leazer/vibranode-probe/LICENSING.md

# Licensing

The first-party software identified below is available under the [PolyForm Noncommercial License 1.0.0](LICENSE-PolyForm-Noncommercial-1.0.0.md). Commercial use of that software requires a separate grant from the relevant rights holder. Contact the maintainer through the original GitHub project for commercial licensing.

Required Notice: Copyright (c) 2026 煲仔卤煮 (ZealerLu)

This grant covers only material for which the project author holds the necessary rights. Existing third-party license and copyright notices remain applicable to the corresponding material.

The first-party software covered here is the original VibraNode probe code in `project/src/probe_*.c` and `project/inc/probe_*.h`, together with the original PC test client `tests/pc_host.py`. This grant excludes vendor code, bundled middleware and hardware design material.

The `libraries/` and `middlewares/` trees and vendor-supplied project templates retain their applicable terms, including the notices in [SEGGER RTT](middlewares/SEGGER_RTT_V798g/LICENSE.md) and [AGM](middlewares/agm/LICENSE.txt).
