leazer/vibranode-probe/docs/milestones/2026-09-07-calib-storage.md

# M8 校准与 Flash 保存

## 2026-09-08 线缆接口与 ICM 加速度

- 记录升级为v3：保留ADXL加速度与ICM陀螺字段，新增独立ICM加速度偏置/比例与有效位；有效v2记录可迁移到RAM，下一次显式保存写v3。
- `probe_calib`持有单一非阻塞会话状态：两组六面均值、窗口统计、连续性、超时、候选与dirty标志。ADXL/ICM加速度按当前量程计算名义灵敏度，ICM陀螺按当前量程换算；每面/静止窗口采集当前ODR约1秒。
- CALIBRATE 0x07支持查询、开始单面/陀螺窗口、取消、清进度；SAVE_CAL 0x08支持读RAM候选和双路停止后显式保存。PC主机支持完整六面、单面断点、陀螺窗口、读取及可选保存。
- 标定只观察已成功上传并即将释放的原始批次；TX忙重试不会重复计入。交互等待期间主机持续FETCH并在开始窗口前排空旧队列，避免4Mbps空闲回退与陈旧批次污染。

仿真覆盖ICM六面拟合、200SPS逐面窗口、v2迁移、v3双记录/掉电中断、协议状态/记录编码、停止后保存幂等；全部组件回归通过。模式0最终完整Rebuild 0错0警：Code53528/RO2324/RW16/ZI29792，SRAM余量2960字节（约2.9KiB）。

实板COM13/4Mbps/slow：0x08读取空白v3默认记录成功；ICM陀螺200样本静止窗口通过两次，未写Flash，最近候选约`(-0.2334,-0.3386,-0.0835)dps`、温度32.246°C；ICM加速度+Z单面200样本通过，完成掩码0x10。交互等待约14秒仍维持ADXL250SPS/ICM约198SPS、CRC零。其余五面和完整拟合需要人工翻转探头，尚未实板完成；当前候选未保存。

日期：2026-09-07，2026-09-08补齐线缆入口。开发分支 `codex/probe-foundation`，前一里程碑 `6083b8b`。依据：[探头设计](../../../../../docs/superpowers/specs/2026-09-06-vibranode-probe-design.md) 第 7 节。

## 本次实现

- `probe_calib` 组件：
  - 六面加速度校准代数拟合（每轴 ±1 g 对：比例 = (p−n)/2 counts/g，零偏 = (p+n)/2），输出按规范语义保存：`accel_bias_g` 物理单位、`accel_scale` 无量纲修正系数（(raw−bias)×scale = g）。内置质量门：任一轴 counts/g 偏离 ±10 g 名义值 50% 以上拒绝，轴间比例差超过 5% 拒绝。
  - 陀螺静止零偏拟合（输入已换算 dps）。
  - 双记录 Flash 存储：256 KB 末两个 2 KB 扇区各存一份记录（magic/version/有效位/三轴零偏与比例/温度/时间戳/CRC-32C），保存写入较旧槽位（掉电不破坏新记录），上电取最新有效记录，CRC 损坏自动回退，全部无效回退默认（比例 1、零偏 0）。
- 上电加载接入生产模式。

## 验证

- calib 仿真测试：注入已知零偏/灵敏度误差的六面数据 → 零偏恢复 ±0.001 g、比例恢复 ±0.001；姿态错乱触发质量门拒绝；保存/重启加载/双记录轮换/损坏回退全部通过；假 Flash 按扇区粒度擦除。
- 全部 10 个测试组件回归通过；Keil 完整 Rebuild 0 错误 0 警告：Code=43532、RO-data=2424、RW-data=16、ZI-data=27040（SRAM 32 KB 余量约 5.7 KB）。
- HEX SHA256：`1A19802ED82F315A9238E9D147BB65CC7EDE412FCBA8B2F20E8E7F360D964127`。

## 尚未验收的边界

Flash 擦写耐久、真实断电时序、ADXL完整六面和ICM其余五面仍未上板验证。校准记录仅存储未应用，应用在 TAB5 分析端。
