leazer/vibranode-probe/docs/milestones/2026-09-07-rtt-board-feedback.md

# 首轮单板 RTT 实板反馈与修复

用户回传日志包含旧M2、M3和新版BOARD多段；本结论仅分析行3454起的新版单板段（929条BOARD日志）。原附件SHA256：`d64f14b0dc2f50c5f3a6ad74321075f5d3f481a1a5213811cd1f455ee0e32ab0`。日志覆盖上电至约246秒，中间有明显输出缺口及连接中断，不是完整连续记录，也未达到30分钟验收。

## 实板观察

- 所有已输出的BOARD `spi/ovr/fmt/qdrop/attdrop/fault` 均为0，默认档首末样本计数差对应ADXL约4054.04 SPS、ICM约8038.43 SPS；后段32k档约32154.27 SPS。计数与消费数相等，未观察到队列丢失。
- ADXL默认档 `time_valid=1`，周期约16166000 Q16.16（约246.67 µs）。ICM高速档IRQ计数保持不变、样本持续增加，但 `time_valid/tick_valid` 不收敛。200 SPS短暂出现有效，记录不足以判断长期表现。
- 默认档AGM `valid=1`、processed持续增长，切到非8k档关闭，回到8k重新运行。仅证明本轮输出存在，不代表振动下姿态精度、轴向或yaw漂移已验收。
- `g` 在约115.140秒启动，约116.135秒通过；候选陀螺零偏为−0.224/−0.330/−0.098 dps，flags=2、dirty=1。运行中`v`正确拒绝。未见 `x/w/SAVE PASS`，因此未验证Flash写入/掉电/重载；也未执行ADXL六面流程。
- 最大观测单轮耗时：采集117 µs，姿态578 µs，总轮询991 µs。所有88条栈报告均为0/2048，不能用本日志验收栈预算。

## 根因和修复

1. **栈水位失真**：默认链接的STACK仍被ARM C运行库作为ZI清零。首版在Reset_Handler中填充，执行到`__main`后就被清掉。用实际AXF执行Reset→CRT→main已复现；首版测试停在SystemInit之前，漏测CRT，这是测试覆盖缺陷。
   - 改为main第一步调用leaf汇编`probe_stack_init`，在CRT之后、板级初始化之前，只填充栈底到当前MSP，保留活动栈帧。水位覆盖之后执行的板级初始化、应用、中断，不覆盖之前的CRT/SystemInit。
   - 不因旧日志0值盲目扩大栈；仍保留2 KiB，必须用新镜像确认真实余量。旧0值不排除其他实际栈风险。
2. **ICM时钟映射依赖停止更新的水位IRQ**：轮询及时排空FIFO后，水位条件不再成立；样本仍正常产生，但估计器拿不到新IRQ锚点。
   - ICM改用FIFO_COUNT请求/完成时刻中点，减去半周期样本年龄；超过512 B时减去仍留在FIFO尾部的样本时长，使锚点对应本批实际末样本。
   - ICM周期和tick比例采用至少100 ms观测跨度，连续8次一致才有效。ADXL保留DRDY与10 ms跨度。此观测包含SPI请求/主循环收割延迟及采样相位误差，不具有精确IRQ捕获的含义，绝对精度仍需外部时基验证。
3. **批次时间未随序号投影**：旧公式把保留的anchor_us当作每批新末样本时刻，估计窗口内批首时间会重复。现在按当前first_sequence相对anchor_seq投影。
4. **TIME_INFO仍用旧IRQ时间**：改为与first_sensor_tick/first_sequence对应的first_sample_us；线上字段布局不变。真实485/TAB5验证继续后移。

## 软件验证

- 现场回归模型由独立124 µs时钟产生ICM样本，FIFO低于水位、没有ICM IRQ；修复前不能收敛，修复后time/tick均有效、估计周期符合独立时钟，并验证相邻批首时间推进。
- 追加200/16000/32000 SPS无IRQ场景，均通过。仿真未涵盖所有寄存器采样相位和>512 B积压时的绝对误差分布，需结合实板数据继续评估。
- 协议测试无ICM IRQ时TIME_INFO时间推进且与对应STREAM批首时刻相等；修复前失败，修复后通过。
- 实际AXF验证执行完整CRT（仅跳过硬件SystemInit），停于板级时钟初始化入口，检查水位未被清除、检测人工覆盖，并检查链接段未侵入Flash标定区。
- 11个组件回归和时间回绕测试通过；四模式完整Rebuild均0错误0警告。只读审查发现的TIME_INFO关联问题已修复。

| 模式 | Code | RO | RW | ZI |
|---|---:|---:|---:|---:|
| 0 | 43944 | 2424 | 16 | 27336 |
| 1 | 18212 | 1756 | 16 | 6256 |
| 2 | 21696 | 2052 | 16 | 15248 |
| 3 | 47336 | 4000 | 16 | 22408 |

模式3剩余RAM10344 B（约10.1 KiB），模式0剩余5416 B（约5.3 KiB），均含2 KiB栈预留。新增两个64位COUNT时刻集中在各设备上下文，总ZI增加32 B。

默认模式3镜像 `project/MDK_V5/objects/VibraNode.hex`，SHA256：`CD9921E070ABC0871698F15C463887A5C0885D68E5CDEE1BA71C5A2633E252AF`。

## 下一步

重新烧录修复版模式3，默认静止10秒，检查ICM两个valid位及真实栈余量；随后2/3/4各至少10秒再回1。先依据新水位/错误计数决定是否继续长时/校准写Flash；不把本轮软件修复声称为实板验收通过。步骤见 [HARDWARE_CHECK_RTT.md](../HARDWARE_CHECK_RTT.md)。

## 修复版第二轮实板反馈（2026-09-07）

附件SHA256 `09317e0c053fe7e53cfc61d0c8b11841cfd5feda4de2ad10fef1527111c01d84`，610行，约0～67秒；上电后到9秒存在输出缺口，不能据此确定首次收敛的精确时刻。顺序默认→4（32k）→3（16k）→2（250/200）→1（默认）。

- 所有已输出spi/ovr/fmt/qdrop/attdrop/fault为0，seg=1、gap=0，消费数跟随样本数。默认档32秒计数窗口约ADXL4054.05/ICM8038.37 SPS；32k档7秒窗口32154.71 SPS；16k档8秒窗口16077.12 SPS。低速仅短窗口，约ADXL253.5/ICM201 SPS，不作精度验收。
- ICM在200/8k/16k/32k均出现time_valid=1、tick_valid=1。默认初段uncertain_batches保持3461不增长，返回默认后稳定3483；切档后短暂无效属于重新估计。说明无持续水位IRQ的收敛修复在这些短时档位得到实板验证。
- 全部59条栈报告均1280/2048，覆盖边界约用768字节；此前0报告确属无效水位，现仪表有实际读数。本轮未覆盖六面、保存Flash等调用路径，不将1280字节余量解释为全路径保证。
- PERF累计最大值：acq116 µs、attitude421 µs、loop983 µs；采集层poll_gap最大984 µs。AGM默认档valid=1且持续输出，非8k档关闭，回到8k重新运行。
- ICM稳态tick_q16约69570（约1.0616 MCU µs/tick），不同高速ODR接近一致；这是映射估计值，不强行当作名义1 µs，也不据此声称绝对时间精度已验收。外部时基验证仍待执行。
- 本轮没有校准/保存命令，启动flags=0；不能声称Flash、六面或长时已通过。

下一步：保持当前固件，默认档长时运行至少30分钟，记录末尾错误计数/PERF/栈；验证x/s/r、LED巡检及静止/轻缓转动。随后g→通过→x→两路stop=1→w→v→复位核对generation/系数，再做ADXL六面。485/TAB5继续后移。本次仅记录验证结果，无固件修改。
