leazer/vibranode-probe/docs/superpowers/plans/2026-09-07-sensor-components.md

# 传感器组件分层整改

目标：保留 M2 已实测行为，分离芯片操作和板级调用，不在本次重构中增加 FIFO 或正式协议。

依据：用户本轮审查要求及仓库 AGENTS.md。使用现有固件分支继续执行。

- [x] 将参考库的必要寄存器定义归入 middlewares，保留来源与版权。
- [x] ADXL357、ICM42688 分别提供无 MCU 依赖的命令编码、身份检查、快照解析和明确命名的诊断配置。
- [x] probe_validation 只保留诊断编排、状态和统计；SPI DMA 继续拥有异步缓冲。
- [x] CS、LED、RS485 DIR 统一使用 wk_config 的板级宏，增加后续开发约束。
- [x] 验证重构前后寄存器事务一致、状态机回归、SPI 回归和 Keil 全量编译，检查 diff 后提交。

状态所有权：芯片描述与配置为只读常量；芯片操作无持久状态。诊断上下文拥有诊断进度、计数、最后一次样本；DMA 上下文拥有传输缓冲和完成状态。后续连续采集状态属于采集组件，不能继续加入诊断上下文。
