leazer/vibranode-probe/docs/milestones/2026-10-12-on-board-calibration.md

# 2026-10-12 实板标定收官（ADXL 六面 + ICM 加计六面 + ICM 陀螺静态）

## 结果

最终记录 v3：`flags=0x07、generation=3、temp_c=30.4`；断电重上电后 `--read-cal`
读回与保存时逐位一致——双槽 + generation + CRC 的持久化与加载链路闭环。

| 目标 | bias | scale |
| --- | --- | --- |
| ADXL 加计 | (−46.84, +47.08, +16.58) mg | (1.03926, 1.02806, 1.07403) |
| ICM 加计 | (−0.31, −1.09, +9.37) mg | (1.00067, 1.00088, 1.00117) |
| ICM 陀螺 | (+0.190, −0.650, +0.674) dps | —（静态零偏） |

## 过程与判读

- 首跑 +X 面被拒（sample_count=250 采满、last_result=REJECTED、采集健康）→
  `pc_host --inspect` 扩展逐轴 mean/std（`9a4a389`）取证 → 根因=
  **PCB 丝印 X/Y 标反**：丝印 +X=传感器 +Y、丝印 +Y=传感器 +X，Z 与极性
  正确；ADXL 与 ICM 两片映射一致 → 板级丝印层错，非器件贴装差。
- 处置：固件/协议零改动（数据、标定记录、姿态全在传感器系）；人工放板按
  传感器系（+X 提示→丝印 Y 朝上，+Y 提示→丝印 X 朝上，±Z 不变）。
- ADXL scale≈1.03 是预期基线：固件 nominal 用 2²⁰ 理想值 52428.8 LSB/g，
  典型灵敏度 51200 LSB/g。Z 的 1.074 曾疑出线端面线缆污染，被**新朝向复现
  检验**否定：两拍独立 dump 代入 corrected=(raw/52428.8−bias)·scale 得
  |g|=1.0002 / 1.0004 → Z 是该片真实灵敏度（较典型 −4.7%），X/Y ±47mg 镜像
  bias 为真实零偏（(p+n)/2 精确恢复；几何倾斜只贡献 ~11mg 量级）。
- ICM 陀螺偏置与两拍独立 dump（+0.205/−0.635/+0.647、+0.203/−0.655/+0.661
  dps）一致，静态可标。
- 工程量：每面 1 s 采集（紫 5 Hz），朝向门 ≤~8.6°（出线端面书堆搭桥、线缆
  留松弛防方差门拒收）。

## 工具

- `pc_host`：`--calibrate adxl-accel|icm-accel|icm-gyro [--face N]` +
  `--save-cal` + `--read-cal`；`--inspect` 打印 ADXL 三轴 / ICM 六轴
  mean±std（slow 配置换算 g/dps），标定诊断与记录复核两用。
- 下一块板：丝印修版前，标定放板沿用本文映射表（X/Y 互换）。

## 遗留观察

- icm_a（侧立）末帧姿态四元数与 90° 倾斜姿态不符——待姿态专项验证时核对
  参考系定义/收尾晃动，不阻塞标定与产品档位。
- LED 故障注入（测量中拔 ADXL=红常亮、拔 ICM=红 5 Hz 闪）仍未做。
