leazer/vibranode-probe/project/inc/at32f413_wk_config.h

/* add user code begin Header */
/**
  **************************************************************************
  * @file     at32f413_wk_config.h
  * @brief    header file of work bench config
  **************************************************************************
  * Copyright (c) 2025, Artery Technology, All rights reserved.
  *
  * The software Board Support Package (BSP) that is made available to
  * download from Artery official website is the copyrighted work of Artery.
  * Artery authorizes customers to use, copy, and distribute the BSP
  * software and its related documentation for the purpose of design and
  * development in conjunction with Artery microcontrollers. Use of the
  * software is governed by this copyright notice and the following disclaimer.
  *
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
  **************************************************************************
  */
/* add user code end Header */

/* define to prevent recursive inclusion -----------------------------------*/
#ifndef __AT32F413_WK_CONFIG_H
#define __AT32F413_WK_CONFIG_H

#ifdef __cplusplus
extern "C" {
#endif

/* includes -----------------------------------------------------------------------*/
#include "stdio.h"
#include "at32f413.h"

/* private includes -------------------------------------------------------------*/
/* add user code begin private includes */
#include "wk_system.h"
/* add user code end private includes */

/* exported types -------------------------------------------------------------*/
/* add user code begin exported types */

/* add user code end exported types */

/* exported constants --------------------------------------------------------*/
/* add user code begin exported constants */

/* add user code end exported constants */

/* exported macro ------------------------------------------------------------*/
/* add user code begin exported macro */

/* add user code end exported macro */

/* add user code begin dma define */
/* user can only modify the dma define value */
//#define DMA1_CHANNEL1_BUFFER_SIZE   0
//#define DMA1_CHANNEL1_MEMORY_BASE_ADDR   0
//#define DMA1_CHANNEL1_PERIPHERAL_BASE_ADDR  0

//#define DMA1_CHANNEL2_BUFFER_SIZE   0
//#define DMA1_CHANNEL2_MEMORY_BASE_ADDR   0
//#define DMA1_CHANNEL2_PERIPHERAL_BASE_ADDR   0

//#define DMA1_CHANNEL3_BUFFER_SIZE   0
//#define DMA1_CHANNEL3_MEMORY_BASE_ADDR   0
//#define DMA1_CHANNEL3_PERIPHERAL_BASE_ADDR   0

//#define DMA1_CHANNEL4_BUFFER_SIZE   0
//#define DMA1_CHANNEL4_MEMORY_BASE_ADDR   0
//#define DMA1_CHANNEL4_PERIPHERAL_BASE_ADDR   0

//#define DMA1_CHANNEL5_BUFFER_SIZE   0
//#define DMA1_CHANNEL5_MEMORY_BASE_ADDR   0
//#define DMA1_CHANNEL5_PERIPHERAL_BASE_ADDR   0

//#define DMA1_CHANNEL6_BUFFER_SIZE   0
//#define DMA1_CHANNEL6_MEMORY_BASE_ADDR   0
//#define DMA1_CHANNEL6_PERIPHERAL_BASE_ADDR   0

//#define DMA1_CHANNEL7_BUFFER_SIZE   0
//#define DMA1_CHANNEL7_MEMORY_BASE_ADDR   0
//#define DMA1_CHANNEL7_PERIPHERAL_BASE_ADDR   0

//#define DMA2_CHANNEL1_BUFFER_SIZE   0
//#define DMA2_CHANNEL1_MEMORY_BASE_ADDR   0
//#define DMA2_CHANNEL1_PERIPHERAL_BASE_ADDR   0

//#define DMA2_CHANNEL2_BUFFER_SIZE   0
//#define DMA2_CHANNEL2_MEMORY_BASE_ADDR   0
//#define DMA2_CHANNEL2_PERIPHERAL_BASE_ADDR   0

//#define DMA2_CHANNEL3_BUFFER_SIZE   0
//#define DMA2_CHANNEL3_MEMORY_BASE_ADDR   0
//#define DMA2_CHANNEL3_PERIPHERAL_BASE_ADDR   0

//#define DMA2_CHANNEL4_BUFFER_SIZE   0
//#define DMA2_CHANNEL4_MEMORY_BASE_ADDR   0
//#define DMA2_CHANNEL4_PERIPHERAL_BASE_ADDR   0

//#define DMA2_CHANNEL5_BUFFER_SIZE   0
//#define DMA2_CHANNEL5_MEMORY_BASE_ADDR   0
//#define DMA2_CHANNEL5_PERIPHERAL_BASE_ADDR   0

//#define DMA2_CHANNEL6_BUFFER_SIZE   0
//#define DMA2_CHANNEL6_MEMORY_BASE_ADDR   0
//#define DMA2_CHANNEL6_PERIPHERAL_BASE_ADDR   0

//#define DMA2_CHANNEL7_BUFFER_SIZE   0
//#define DMA2_CHANNEL7_MEMORY_BASE_ADDR   0
//#define DMA2_CHANNEL7_PERIPHERAL_BASE_ADDR   0
/* add user code end dma define */

/* Private defines -------------------------------------------------------------*/
#define ADXL_CS_PIN    GPIO_PINS_4
#define ADXL_CS_GPIO_PORT    GPIOA
#define ADXL_CLK_PIN    GPIO_PINS_5
#define ADXL_CLK_GPIO_PORT    GPIOA
#define ADXL_MISO_PIN    GPIO_PINS_6
#define ADXL_MISO_GPIO_PORT    GPIOA
#define ADXL_MOSI_PIN    GPIO_PINS_7
#define ADXL_MOSI_GPIO_PORT    GPIOA
#define ADXL_DRDY_PIN    GPIO_PINS_0
#define ADXL_DRDY_GPIO_PORT    GPIOB
#define ADXL_INT1_PIN    GPIO_PINS_1
#define ADXL_INT1_GPIO_PORT    GPIOB
#define IMU_INT1_PIN    GPIO_PINS_10
#define IMU_INT1_GPIO_PORT    GPIOB
#define IMU_CS_PIN    GPIO_PINS_12
#define IMU_CS_GPIO_PORT    GPIOB
#define IMU_CLK_PIN    GPIO_PINS_13
#define IMU_CLK_GPIO_PORT    GPIOB
#define IMU_MISO_PIN    GPIO_PINS_14
#define IMU_MISO_GPIO_PORT    GPIOB
#define IMU_MOSI_PIN    GPIO_PINS_15
#define IMU_MOSI_GPIO_PORT    GPIOB
#define LED_R_PIN    GPIO_PINS_5
#define LED_R_GPIO_PORT    GPIOB
#define LED_G_PIN    GPIO_PINS_3
#define LED_G_GPIO_PORT    GPIOB
#define LED_B_PIN    GPIO_PINS_4
#define LED_B_GPIO_PORT    GPIOB

/* exported functions ------------------------------------------------------- */
  /* system clock config. */
  void wk_system_clock_config(void);

  /* config periph clock. */
  void wk_periph_clock_config(void);

  /* init debug function. */
  void wk_debug_config(void);

  /* nvic config. */
  void wk_nvic_config(void);

  /* init gpio function. */
  void wk_gpio_config(void);

  /* init exint function. */
  void wk_exint_config(void);

  /* init spi1 function. */
  void wk_spi1_init(void);

  /* init spi2 function. */
  void wk_spi2_init(void);

/* add user code begin exported functions */

/* add user code end exported functions */

#ifdef __cplusplus
}
#endif

#endif
