leazer/vibranode-probe/project/src/at32f413_wk_config.c

/* add user code begin Header */
/**
  **************************************************************************
  * @file     at32f413_wk_config.c
  * @brief    work bench config program
  **************************************************************************
  * Copyright (c) 2025, Artery Technology, All rights reserved.
  *
  * The software Board Support Package (BSP) that is made available to
  * download from Artery official website is the copyrighted work of Artery.
  * Artery authorizes customers to use, copy, and distribute the BSP
  * software and its related documentation for the purpose of design and
  * development in conjunction with Artery microcontrollers. Use of the
  * software is governed by this copyright notice and the following disclaimer.
  *
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
  **************************************************************************
  */
/* add user code end Header */

#include "at32f413_wk_config.h"

/* private includes ----------------------------------------------------------*/
/* add user code begin private includes */

/* add user code end private includes */

/* private typedef -----------------------------------------------------------*/
/* add user code begin private typedef */

/* add user code end private typedef */

/* private define ------------------------------------------------------------*/
/* add user code begin private define */

/* add user code end private define */

/* private macro -------------------------------------------------------------*/
/* add user code begin private macro */

/* add user code end private macro */

/* private variables ---------------------------------------------------------*/
/* add user code begin private variables */

/* add user code end private variables */

/* private function prototypes --------------------------------------------*/
/* add user code begin function prototypes */

/* add user code end function prototypes */

/* private user code ---------------------------------------------------------*/
/* add user code begin 0 */

/* add user code end 0 */

/**
  * @brief  system clock config program
  * @note   the system clock is configured as follow:
  *         system clock (sclk)   = hext / 2 * pll_mult
  *         system clock source   = HEXT_VALUE
  *         - hext                = HEXT_VALUE
  *         - sclk                = 200000000
  *         - ahbdiv              = 1
  *         - ahbclk              = 200000000
  *         - apb1div             = 2
  *         - apb1clk             = 100000000
  *         - apb2div             = 2
  *         - apb2clk             = 100000000
  *         - pll_mult            = 50
  *         - pll_range           = GT72MHZ (greater than 72 mhz)
  *         - usb clock           = HICK 48 MHz (see probe_usb.c). 200 MHz is
  *                                  the part maximum and is only reachable
  *                                  with the HICK USB clock (200/4 != 48).
  * @param  none
  * @retval none
  */
void wk_system_clock_config(void)
{
  /* reset crm */
  crm_reset();

  /* enable lick */
  crm_clock_source_enable(CRM_CLOCK_SOURCE_LICK, TRUE);

  /* wait till lick is ready */
  while(crm_flag_get(CRM_LICK_STABLE_FLAG) != SET)
  {
  }

  /* enable hext */
  crm_clock_source_enable(CRM_CLOCK_SOURCE_HEXT, TRUE);

  /* wait till hext is ready */
  while(crm_hext_stable_wait() == ERROR)
  {
  }

  /* enable hick */
  crm_clock_source_enable(CRM_CLOCK_SOURCE_HICK, TRUE);

  /* wait till hick is ready */
  while(crm_flag_get(CRM_HICK_STABLE_FLAG) != SET)
  {
  }

  /* config pll clock resource */
  crm_pll_config(CRM_PLL_SOURCE_HEXT_DIV, CRM_PLL_MULT_50, CRM_PLL_OUTPUT_RANGE_GT72MHZ);

  /* enable pll */
  crm_clock_source_enable(CRM_CLOCK_SOURCE_PLL, TRUE);

  /* wait till pll is ready */
  while(crm_flag_get(CRM_PLL_STABLE_FLAG) != SET)
  {
  }

  /* config ahbclk */
  crm_ahb_div_set(CRM_AHB_DIV_1);

  /* config apb2clk, the maximum frequency of APB2 clock is 100 MHz  */
  crm_apb2_div_set(CRM_APB2_DIV_2);

  /* config apb1clk, the maximum frequency of APB1 clock is 100 MHz  */
  crm_apb1_div_set(CRM_APB1_DIV_2);

  /* enable auto step mode */
  crm_auto_step_mode_enable(TRUE);

  /* select pll as system clock source */
  crm_sysclk_switch(CRM_SCLK_PLL);

  /* wait till pll is used as system clock source */
  while(crm_sysclk_switch_status_get() != CRM_SCLK_PLL)
  {
  }

  /* disable auto step mode */
  crm_auto_step_mode_enable(FALSE);

  /* update system_core_clock global variable */
  system_core_clock_update();
}

/**
  * @brief  config periph clock
  * @param  none
  * @retval none
  */
void wk_periph_clock_config(void)
{
  /* enable iomux periph clock */
  crm_periph_clock_enable(CRM_IOMUX_PERIPH_CLOCK, TRUE);

  /* enable gpioa periph clock */
  crm_periph_clock_enable(CRM_GPIOA_PERIPH_CLOCK, TRUE);

  /* enable gpiob periph clock */
  crm_periph_clock_enable(CRM_GPIOB_PERIPH_CLOCK, TRUE);

  /* enable gpiod periph clock */
  crm_periph_clock_enable(CRM_GPIOD_PERIPH_CLOCK, TRUE);

  /* enable spi1 periph clock */
  crm_periph_clock_enable(CRM_SPI1_PERIPH_CLOCK, TRUE);

  /* enable spi2 periph clock */
  crm_periph_clock_enable(CRM_SPI2_PERIPH_CLOCK, TRUE);
}

/**
  * @brief  init debug function.
  * @param  none
  * @retval none
  */
void wk_debug_config(void)
{
  /* jtag-dp disabled and sw-dp enabled */
  gpio_pin_remap_config(SWJTAG_GMUX_010, TRUE);
}

/**
  * @brief  nvic config
  * @param  none
  * @retval none
  */
void wk_nvic_config(void)
{
  nvic_priority_group_config(NVIC_PRIORITY_GROUP_4);

  NVIC_SetPriority(MemoryManagement_IRQn, NVIC_EncodePriority(NVIC_GetPriorityGrouping(), 0, 0));
  NVIC_SetPriority(BusFault_IRQn, NVIC_EncodePriority(NVIC_GetPriorityGrouping(), 0, 0));
  NVIC_SetPriority(UsageFault_IRQn, NVIC_EncodePriority(NVIC_GetPriorityGrouping(), 0, 0));
  NVIC_SetPriority(SVCall_IRQn, NVIC_EncodePriority(NVIC_GetPriorityGrouping(), 0, 0));
  NVIC_SetPriority(DebugMonitor_IRQn, NVIC_EncodePriority(NVIC_GetPriorityGrouping(), 0, 0));
  NVIC_SetPriority(PendSV_IRQn, NVIC_EncodePriority(NVIC_GetPriorityGrouping(), 15, 0));
  NVIC_SetPriority(SysTick_IRQn, NVIC_EncodePriority(NVIC_GetPriorityGrouping(), 15, 0));
}

/**
  * @brief  init gpio_input/gpio_output/gpio_analog/eventout function.
  * @param  none
  * @retval none
  */
void wk_gpio_config(void)
{
  /* add user code begin gpio_config 0 */

  /* add user code end gpio_config 0 */

  gpio_init_type gpio_init_struct;
  gpio_default_para_init(&gpio_init_struct);

  /* add user code begin gpio_config 1 */

  /* add user code end gpio_config 1 */

  /* gpio output config */
  gpio_bits_set(ADXL_CS_GPIO_PORT, ADXL_CS_PIN);
  gpio_bits_set(IMU_CS_GPIO_PORT, IMU_CS_PIN);
  gpio_bits_set(LED_R_GPIO_PORT, LED_R_PIN);
  gpio_bits_set(LED_G_GPIO_PORT, LED_G_PIN);
  gpio_bits_set(LED_B_GPIO_PORT, LED_B_PIN);

  gpio_init_struct.gpio_drive_strength = GPIO_DRIVE_STRENGTH_MODERATE;
  gpio_init_struct.gpio_out_type = GPIO_OUTPUT_PUSH_PULL;
  gpio_init_struct.gpio_mode = GPIO_MODE_OUTPUT;
  gpio_init_struct.gpio_pins = ADXL_CS_PIN;
  gpio_init_struct.gpio_pull = GPIO_PULL_NONE;
  gpio_init(GPIOA, &gpio_init_struct);

  gpio_init_struct.gpio_drive_strength = GPIO_DRIVE_STRENGTH_MODERATE;
  gpio_init_struct.gpio_out_type = GPIO_OUTPUT_PUSH_PULL;
  gpio_init_struct.gpio_mode = GPIO_MODE_OUTPUT;
  gpio_init_struct.gpio_pins = IMU_CS_PIN | LED_R_PIN | LED_G_PIN | LED_B_PIN;
  gpio_init_struct.gpio_pull = GPIO_PULL_NONE;
  gpio_init(GPIOB, &gpio_init_struct);

  /* add user code begin gpio_config 2 */

  /* add user code end gpio_config 2 */
}

/**
  * @brief  init exint function.
  * @param  none
  * @retval none
  */
void wk_exint_config(void)
{
  /* add user code begin exint_config 0 */

  /* add user code end exint_config 0 */

  gpio_init_type gpio_init_struct;
  exint_init_type exint_init_struct;

  /* add user code begin exint_config 1 */

  /* add user code end exint_config 1 */

  /* configure the EXINT0 */
  gpio_default_para_init(&gpio_init_struct);
  gpio_init_struct.gpio_mode = GPIO_MODE_INPUT;
  gpio_init_struct.gpio_pins = ADXL_DRDY_PIN;
  gpio_init_struct.gpio_pull = GPIO_PULL_NONE;
  gpio_init(ADXL_DRDY_GPIO_PORT, &gpio_init_struct);

  gpio_exint_line_config(GPIO_PORT_SOURCE_GPIOB, GPIO_PINS_SOURCE0);

  exint_default_para_init(&exint_init_struct);
  exint_init_struct.line_enable = TRUE;
  exint_init_struct.line_mode = EXINT_LINE_INTERRUPUT;
  exint_init_struct.line_select = EXINT_LINE_0;
  exint_init_struct.line_polarity = EXINT_TRIGGER_RISING_EDGE;
  exint_init(&exint_init_struct);

  /* configure the EXINT1 */
  gpio_default_para_init(&gpio_init_struct);
  gpio_init_struct.gpio_mode = GPIO_MODE_INPUT;
  gpio_init_struct.gpio_pins = ADXL_INT1_PIN;
  gpio_init_struct.gpio_pull = GPIO_PULL_NONE;
  gpio_init(ADXL_INT1_GPIO_PORT, &gpio_init_struct);

  gpio_exint_line_config(GPIO_PORT_SOURCE_GPIOB, GPIO_PINS_SOURCE1);

  exint_default_para_init(&exint_init_struct);
  exint_init_struct.line_enable = TRUE;
  exint_init_struct.line_mode = EXINT_LINE_INTERRUPUT;
  exint_init_struct.line_select = EXINT_LINE_1;
  exint_init_struct.line_polarity = EXINT_TRIGGER_RISING_EDGE;
  exint_init(&exint_init_struct);

  /* configure the EXINT10 */
  gpio_default_para_init(&gpio_init_struct);
  gpio_init_struct.gpio_mode = GPIO_MODE_INPUT;
  gpio_init_struct.gpio_pins = IMU_INT1_PIN;
  gpio_init_struct.gpio_pull = GPIO_PULL_NONE;
  gpio_init(IMU_INT1_GPIO_PORT, &gpio_init_struct);

  gpio_exint_line_config(GPIO_PORT_SOURCE_GPIOB, GPIO_PINS_SOURCE10);

  exint_default_para_init(&exint_init_struct);
  exint_init_struct.line_enable = TRUE;
  exint_init_struct.line_mode = EXINT_LINE_INTERRUPUT;
  exint_init_struct.line_select = EXINT_LINE_10;
  exint_init_struct.line_polarity = EXINT_TRIGGER_RISING_EDGE;
  exint_init(&exint_init_struct);

  /* add user code begin exint_config 2 */

  /* add user code end exint_config 2 */
  
  /* add user code begin exint_config 3 */

  /* add user code end exint_config 3 */
}

/**
  * @brief  init spi1 function
  * @param  none
  * @retval none
  */
void wk_spi1_init(void)
{
  /* add user code begin spi1_init 0 */

  /* add user code end spi1_init 0 */

  gpio_init_type gpio_init_struct;
  spi_init_type spi_init_struct;

  gpio_default_para_init(&gpio_init_struct);
  spi_default_para_init(&spi_init_struct);

  /* add user code begin spi1_init 1 */

  /* add user code end spi1_init 1 */

  /* configure the SCK pin */
  gpio_init_struct.gpio_drive_strength = GPIO_DRIVE_STRENGTH_MODERATE;
  gpio_init_struct.gpio_out_type = GPIO_OUTPUT_PUSH_PULL;
  gpio_init_struct.gpio_mode = GPIO_MODE_MUX;
  gpio_init_struct.gpio_pins = ADXL_CLK_PIN;
  gpio_init_struct.gpio_pull = GPIO_PULL_NONE;
  gpio_init(ADXL_CLK_GPIO_PORT, &gpio_init_struct);

  /* configure the MISO pin */
  gpio_init_struct.gpio_drive_strength = GPIO_DRIVE_STRENGTH_MODERATE;
  gpio_init_struct.gpio_out_type  = GPIO_OUTPUT_PUSH_PULL;
  gpio_init_struct.gpio_mode = GPIO_MODE_INPUT;
  gpio_init_struct.gpio_pins = ADXL_MISO_PIN;
  gpio_init_struct.gpio_pull = GPIO_PULL_NONE;
  gpio_init(ADXL_MISO_GPIO_PORT, &gpio_init_struct);

  /* configure the MOSI pin */
  gpio_init_struct.gpio_drive_strength = GPIO_DRIVE_STRENGTH_MODERATE;
  gpio_init_struct.gpio_out_type = GPIO_OUTPUT_PUSH_PULL;
  gpio_init_struct.gpio_mode = GPIO_MODE_MUX;
  gpio_init_struct.gpio_pins = ADXL_MOSI_PIN;
  gpio_init_struct.gpio_pull = GPIO_PULL_NONE;
  gpio_init(ADXL_MOSI_GPIO_PORT, &gpio_init_struct);

  /* configure param */
  spi_init_struct.transmission_mode = SPI_TRANSMIT_FULL_DUPLEX;
  spi_init_struct.master_slave_mode = SPI_MODE_MASTER;
  spi_init_struct.frame_bit_num = SPI_FRAME_8BIT;
  spi_init_struct.first_bit_transmission = SPI_FIRST_BIT_MSB;
  spi_init_struct.mclk_freq_division = SPI_MCLK_DIV_16;
  spi_init_struct.clock_polarity = SPI_CLOCK_POLARITY_LOW;
  spi_init_struct.clock_phase = SPI_CLOCK_PHASE_1EDGE;
  spi_init_struct.cs_mode_selection = SPI_CS_SOFTWARE_MODE;
  spi_init(SPI1, &spi_init_struct);

  /* add user code begin spi1_init 2 */

  /* add user code end spi1_init 2 */

  spi_enable(SPI1, TRUE);

  /* add user code begin spi1_init 3 */

  /* add user code end spi1_init 3 */
}

/**
  * @brief  init spi2 function
  * @param  none
  * @retval none
  */
void wk_spi2_init(void)
{
  /* add user code begin spi2_init 0 */

  /* add user code end spi2_init 0 */

  gpio_init_type gpio_init_struct;
  spi_init_type spi_init_struct;

  gpio_default_para_init(&gpio_init_struct);
  spi_default_para_init(&spi_init_struct);

  /* add user code begin spi2_init 1 */

  /* add user code end spi2_init 1 */

  /* configure the SCK pin */
  gpio_init_struct.gpio_drive_strength = GPIO_DRIVE_STRENGTH_MODERATE;
  gpio_init_struct.gpio_out_type = GPIO_OUTPUT_PUSH_PULL;
  gpio_init_struct.gpio_mode = GPIO_MODE_MUX;
  gpio_init_struct.gpio_pins = IMU_CLK_PIN;
  gpio_init_struct.gpio_pull = GPIO_PULL_NONE;
  gpio_init(IMU_CLK_GPIO_PORT, &gpio_init_struct);

  /* configure the MISO pin */
  gpio_init_struct.gpio_drive_strength = GPIO_DRIVE_STRENGTH_MODERATE;
  gpio_init_struct.gpio_out_type  = GPIO_OUTPUT_PUSH_PULL;
  gpio_init_struct.gpio_mode = GPIO_MODE_INPUT;
  gpio_init_struct.gpio_pins = IMU_MISO_PIN;
  gpio_init_struct.gpio_pull = GPIO_PULL_NONE;
  gpio_init(IMU_MISO_GPIO_PORT, &gpio_init_struct);

  /* configure the MOSI pin */
  gpio_init_struct.gpio_drive_strength = GPIO_DRIVE_STRENGTH_MODERATE;
  gpio_init_struct.gpio_out_type = GPIO_OUTPUT_PUSH_PULL;
  gpio_init_struct.gpio_mode = GPIO_MODE_MUX;
  gpio_init_struct.gpio_pins = IMU_MOSI_PIN;
  gpio_init_struct.gpio_pull = GPIO_PULL_NONE;
  gpio_init(IMU_MOSI_GPIO_PORT, &gpio_init_struct);

  /* configure param */
  spi_init_struct.transmission_mode = SPI_TRANSMIT_FULL_DUPLEX;
  spi_init_struct.master_slave_mode = SPI_MODE_MASTER;
  spi_init_struct.frame_bit_num = SPI_FRAME_8BIT;
  spi_init_struct.first_bit_transmission = SPI_FIRST_BIT_MSB;
  spi_init_struct.mclk_freq_division = SPI_MCLK_DIV_8;
  spi_init_struct.clock_polarity = SPI_CLOCK_POLARITY_LOW;
  spi_init_struct.clock_phase = SPI_CLOCK_PHASE_1EDGE;
  spi_init_struct.cs_mode_selection = SPI_CS_SOFTWARE_MODE;
  spi_init(SPI2, &spi_init_struct);

  /* add user code begin spi2_init 2 */

  /* add user code end spi2_init 2 */

  spi_enable(SPI2, TRUE);

  /* add user code begin spi2_init 3 */

  /* add user code end spi2_init 3 */
}

/* add user code begin 1 */

/* add user code end 1 */
