leazer/vibranode-probe/project/src/at32f413_int.c

/* add user code begin Header */
/**
  **************************************************************************
  * @file     at32f413_int.c
  * @brief    main interrupt service routines.
  **************************************************************************
  * Copyright (c) 2025, Artery Technology, All rights reserved.
  *
  * The software Board Support Package (BSP) that is made available to
  * download from Artery official website is the copyrighted work of Artery.
  * Artery authorizes customers to use, copy, and distribute the BSP
  * software and its related documentation for the purpose of design and
  * development in conjunction with Artery microcontrollers. Use of the
  * software is governed by this copyright notice and the following disclaimer.
  *
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
  **************************************************************************
  */
/* add user code end Header */

/* includes ------------------------------------------------------------------*/
#include "at32f413_int.h"
#include "wk_system.h"
/* private includes ----------------------------------------------------------*/
/* add user code begin private includes */
#include "probe_time.h"
#include "probe_spi.h"
#include "probe_validation.h"
#include "probe_acquisition.h"
#include "probe_usb.h"

/* add user code end private includes */

/* private typedef -----------------------------------------------------------*/
/* add user code begin private typedef */

/* add user code end private typedef */

/* private define ------------------------------------------------------------*/
/* add user code begin private define */

/* add user code end private define */

/* private macro -------------------------------------------------------------*/
/* add user code begin private macro */

/* add user code end private macro */

/* private variables ---------------------------------------------------------*/
/* add user code begin private variables */

/* add user code end private variables */

/* private function prototypes --------------------------------------------*/
/* add user code begin function prototypes */

/* add user code end function prototypes */

/* private user code ---------------------------------------------------------*/
/* add user code begin 0 */

/* add user code end 0 */

/* external variables ---------------------------------------------------------*/
/* add user code begin external variables */

/* add user code end external variables */

/**
  * @brief  this function handles nmi exception.
  * @param  none
  * @retval none
  */
void NMI_Handler(void)
{
  /* add user code begin NonMaskableInt_IRQ 0 */

  /* add user code end NonMaskableInt_IRQ 0 */

  /* add user code begin NonMaskableInt_IRQ 1 */

  /* add user code end NonMaskableInt_IRQ 1 */
}

/**
  * @brief  this function handles hard fault exception.
  * @param  none
  * @retval none
  */
void HardFault_Handler(void)
{
  /* add user code begin HardFault_IRQ 0 */

  /* add user code end HardFault_IRQ 0 */
  /* go to infinite loop when hard fault exception occurs */
  while (1)
  {
    /* add user code begin W1_HardFault_IRQ 0 */

    /* add user code end W1_HardFault_IRQ 0 */
  }
}


/**
  * @brief  this function handles memory manage exception.
  * @param  none
  * @retval none
  */
void MemManage_Handler(void)
{
  /* add user code begin MemoryManagement_IRQ 0 */

  /* add user code end MemoryManagement_IRQ 0 */
  /* go to infinite loop when memory manage exception occurs */
  while (1)
  {
    /* add user code begin W1_MemoryManagement_IRQ 0 */

    /* add user code end W1_MemoryManagement_IRQ 0 */
  }
}

/**
  * @brief  this function handles bus fault exception.
  * @param  none
  * @retval none
  */
void BusFault_Handler(void)
{
  /* add user code begin BusFault_IRQ 0 */

  /* add user code end BusFault_IRQ 0 */
  /* go to infinite loop when bus fault exception occurs */
  while (1)
  {
    /* add user code begin W1_BusFault_IRQ 0 */

    /* add user code end W1_BusFault_IRQ 0 */
  }
}

/**
  * @brief  this function handles usage fault exception.
  * @param  none
  * @retval none
  */
void UsageFault_Handler(void)
{
  /* add user code begin UsageFault_IRQ 0 */

  /* add user code end UsageFault_IRQ 0 */
  /* go to infinite loop when usage fault exception occurs */
  while (1)
  {
    /* add user code begin W1_UsageFault_IRQ 0 */

    /* add user code end W1_UsageFault_IRQ 0 */
  }
}

/**
  * @brief  this function handles debug monitor exception.
  * @param  none
  * @retval none
  */
void DebugMon_Handler(void)
{
  /* add user code begin DebugMonitor_IRQ 0 */

  /* add user code end DebugMonitor_IRQ 0 */
  /* add user code begin DebugMonitor_IRQ 1 */

  /* add user code end DebugMonitor_IRQ 1 */
}

/**
  * @brief  this function handles systick handler.
  * @param  none
  * @retval none
  */
void SysTick_Handler(void)
{
  /* add user code begin SysTick_IRQ 0 */

  /* add user code end SysTick_IRQ 0 */

  wk_timebase_handler();
  /* add user code begin SysTick_IRQ 1 */

  /* add user code end SysTick_IRQ 1 */
}

/* add user code begin 1 */
void DMA1_Channel1_IRQHandler(void) { probe_spi_dma_isr(PROBE_SPI_ADXL); }
void DMA1_Channel2_IRQHandler(void) { probe_spi_dma_isr(PROBE_SPI_ADXL); }
void DMA1_Channel3_IRQHandler(void) { probe_spi_dma_isr(PROBE_SPI_ICM); }
void DMA1_Channel4_IRQHandler(void) { probe_spi_dma_isr(PROBE_SPI_ICM); }

void EXINT0_IRQHandler(void)
{
  if (exint_interrupt_flag_get(EXINT_LINE_0) == SET) {
    exint_flag_clear(EXINT_LINE_0);
#if PROBE_HARDWARE_VALIDATION == 1
    probe_validation_irq(0);
#else
    probe_acquisition_irq(0);
#endif
  }
}
void EXINT1_IRQHandler(void)
{
  if (exint_interrupt_flag_get(EXINT_LINE_1) == SET) {
    exint_flag_clear(EXINT_LINE_1);
#if PROBE_HARDWARE_VALIDATION == 1
    probe_validation_irq(1);
#else
    probe_acquisition_irq(1);
#endif
  }
}
void EXINT15_10_IRQHandler(void)
{
  if (exint_interrupt_flag_get(EXINT_LINE_10) == SET) {
    exint_flag_clear(EXINT_LINE_10);
#if PROBE_HARDWARE_VALIDATION == 1
    probe_validation_irq(2);
#else
    probe_acquisition_irq(2);
#endif
  }
}

void TMR1_TRG_HALL_TMR11_IRQHandler(void)
{
  /* TMR1 trigger/Hall sources are unused; this vector belongs to TMR11 here. */
  probe_time_overflow_isr();
}

void USBFS_L_CAN1_RX0_IRQHandler(void)
{
  /* CAN1 is unused; this vector is the USB device interrupt. */
  probe_usb_isr();
}

/* add user code end 1 */
