leazer/vibranode-probe/project/inc/probe_dma.h

/**
 * @file probe_dma.h
 * @author 煲仔卤煮(ZealerLu)
 * @date 2026-09-06
 *
 * @copyright Copyright (c) 2026
 *
 */
#ifndef PROBE_DMA_H
#define PROBE_DMA_H
/* Configure request routing and priority only; no transfer is started. */
void probe_dma_init(void);
#endif
